mas-ka/ThermoStat-AC100V/docs/ThermoStat-AC100V_v2_電気回路図.pdf

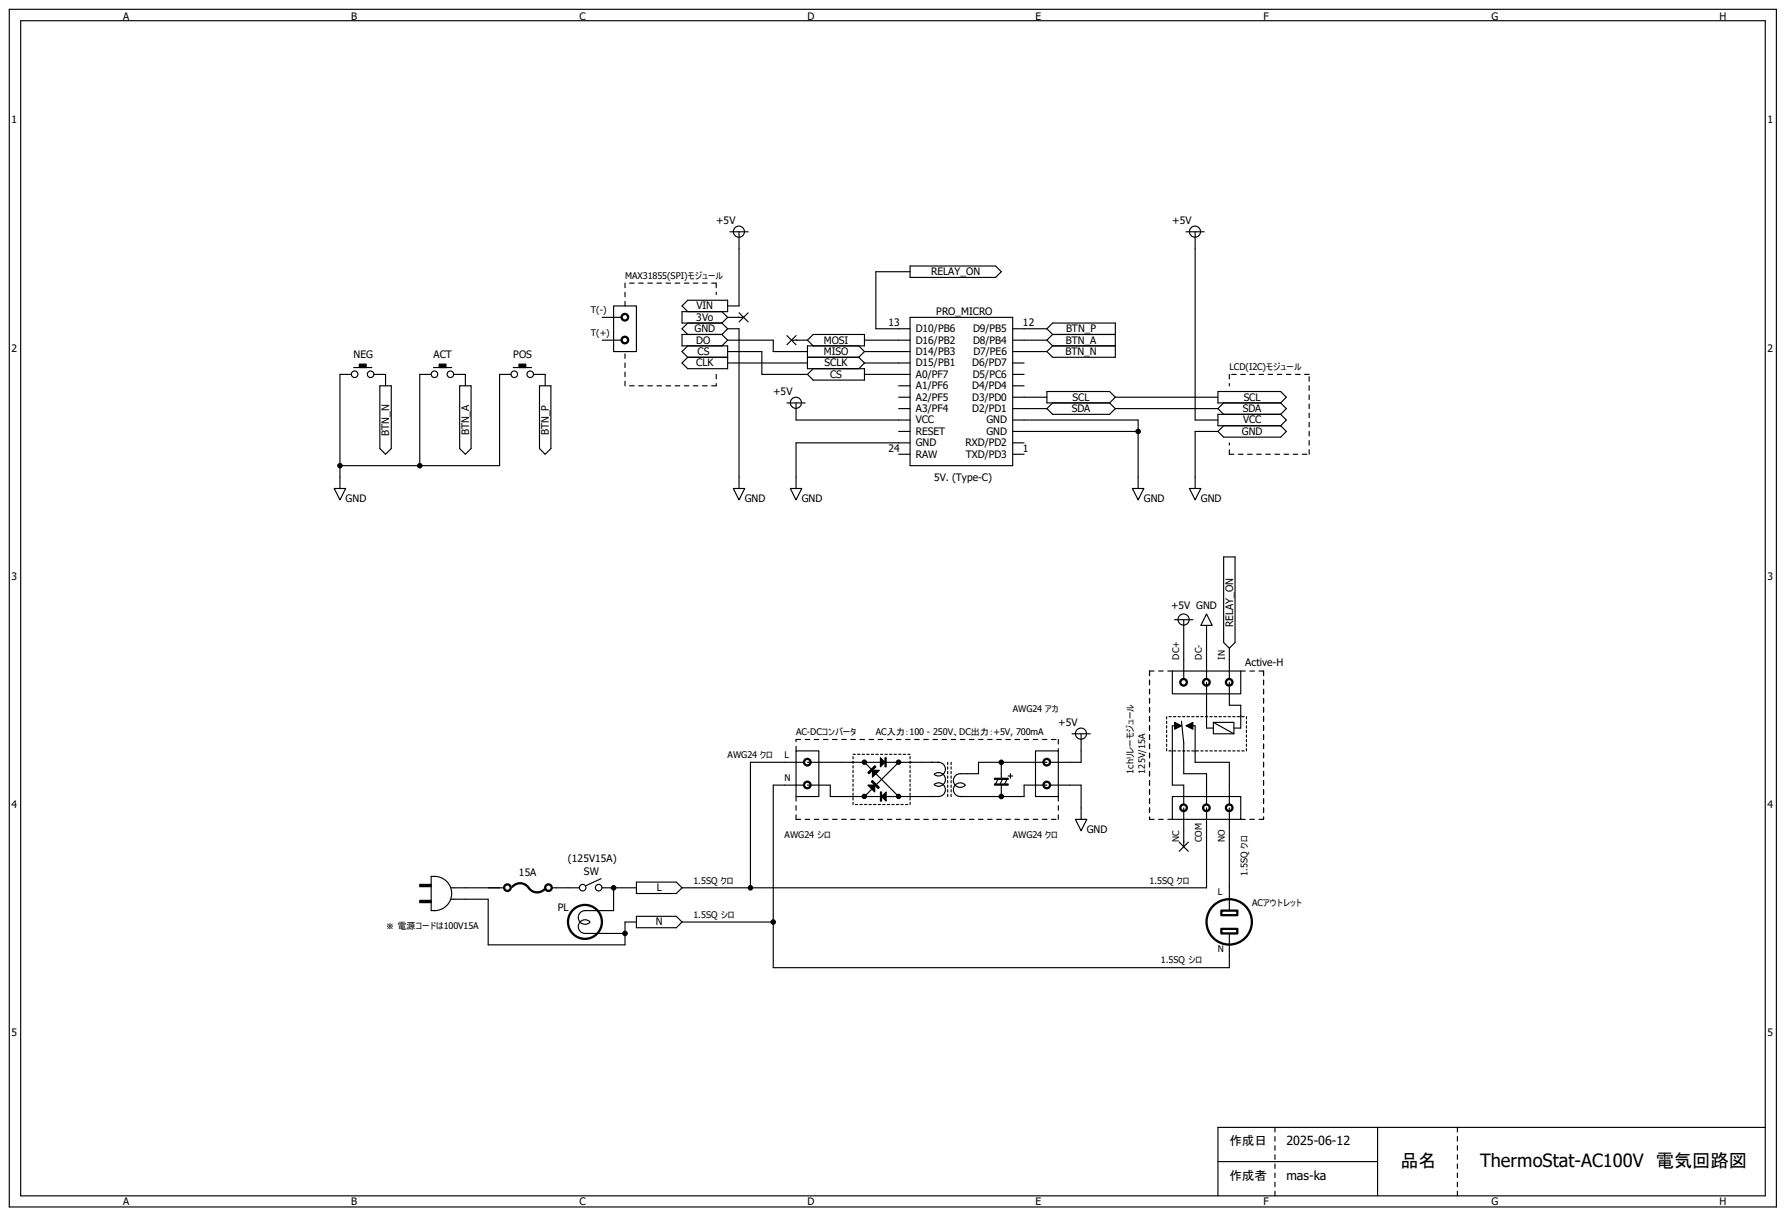
[picture p2: page 1]
ThermoStat-AC100V 電気回路図; AC-DCコンバータ; AC入力：100 - 250V、DC出力：+5V, 700mA; ACアウトレット; COM; NO INDC+; DC⁻ 1chリレーモジュール 125V/15A; LCD(I2C)モジュール; MAX31855(SPI)モジュール; ※ 電源コードは100V15A; AWG24 クロ; AWG24 シロ; AWG24 アカ; Active-H; NEG; ACT; POS; GND; VCC; RESET GND RAW 24; TXD/PD3; RXD/PD2; PRO_MICRO; 5V. (Type-C); +5V GND; N RELAY_ON; SDA; SCL; VCC BTN_N; BTN_A; BTN_P; RELAY_ON; MISO SCLK; MOSI; VIN 3Vo GND DO CS CLK; BTN_N

作成日 | 2025-06-12

作成者 | mas-ka
