mas-ka/ThermoStat-AC100V/(commit log)

2024-03-11 上下ボタン１つの動作デモを作成した
2024-03-11 同時押しを許さない上下ボタン２つの動作デモが書けた
2024-03-11 LCDとボタン３つを制御する本番コード「thermostat-ac100v.ino」を書き始めた
2024-03-12 動作モードとかの表示をカスタムキャラクタでおこなうようにした。
2024-03-12 とりあえず全機能の実装が済んだ。実機動作試験は未実施。
2024-03-12 実機動作試験OK。高頻度でMAX31855にアクセスすると値取得できずエラー判定になるので、状態監視・温度取得・表示・温調制御をすべて同じ500msec間隔のタイミングでおこなうようにした。
2024-04-03 IDL時以外は熱電対読み取りでエラーであってもERRORモードに遷移しないようにした（リレー遮断はおこなう）。
2024-07-22 keyライブラリを使用するよう書き直した。それによりボタン押下の動作が安定し、「IDLE時ACTが長押しで表示だけ先にSETに変わる」が実装できた。ついでに「HI/LO値変更時にACT長押しで値リセット」のあとでモードを設定のままとなるよう変更医した。実機動作試験OK！
2024-07-26 スイッチ処理を「VersatileSwitch」ライブラリに移行した。ClickedやLongClickedより先にReleasedがコールバックされるので、そこらへんの対応が面倒くさいな。実機動作試験OK。
2024-07-26 IDLEやSEL_LO/HIでのACT長押し中の表示だけ変えた際にカーソルがちゃんと点滅するように「PSEUDO_IDLE, PSEUDO_SEL_LO」というモードを新設した。実機動作確認OK。
2025-06-12 v2(小型ボックス筐体)用にピンアサインを変更した。実機動作確認OK！
2026-09-16 docs: README.mdおよび設計資料（回路図・CADデータ）を追加
2026-09-16 docs: MIT LICENSEを追加し、READMEに記載
2026-09-16 図面の作者を「mas-ka」に修正
